dojiDoMal/Heatbed_8051/3DPrinter_Heatbed.PDF

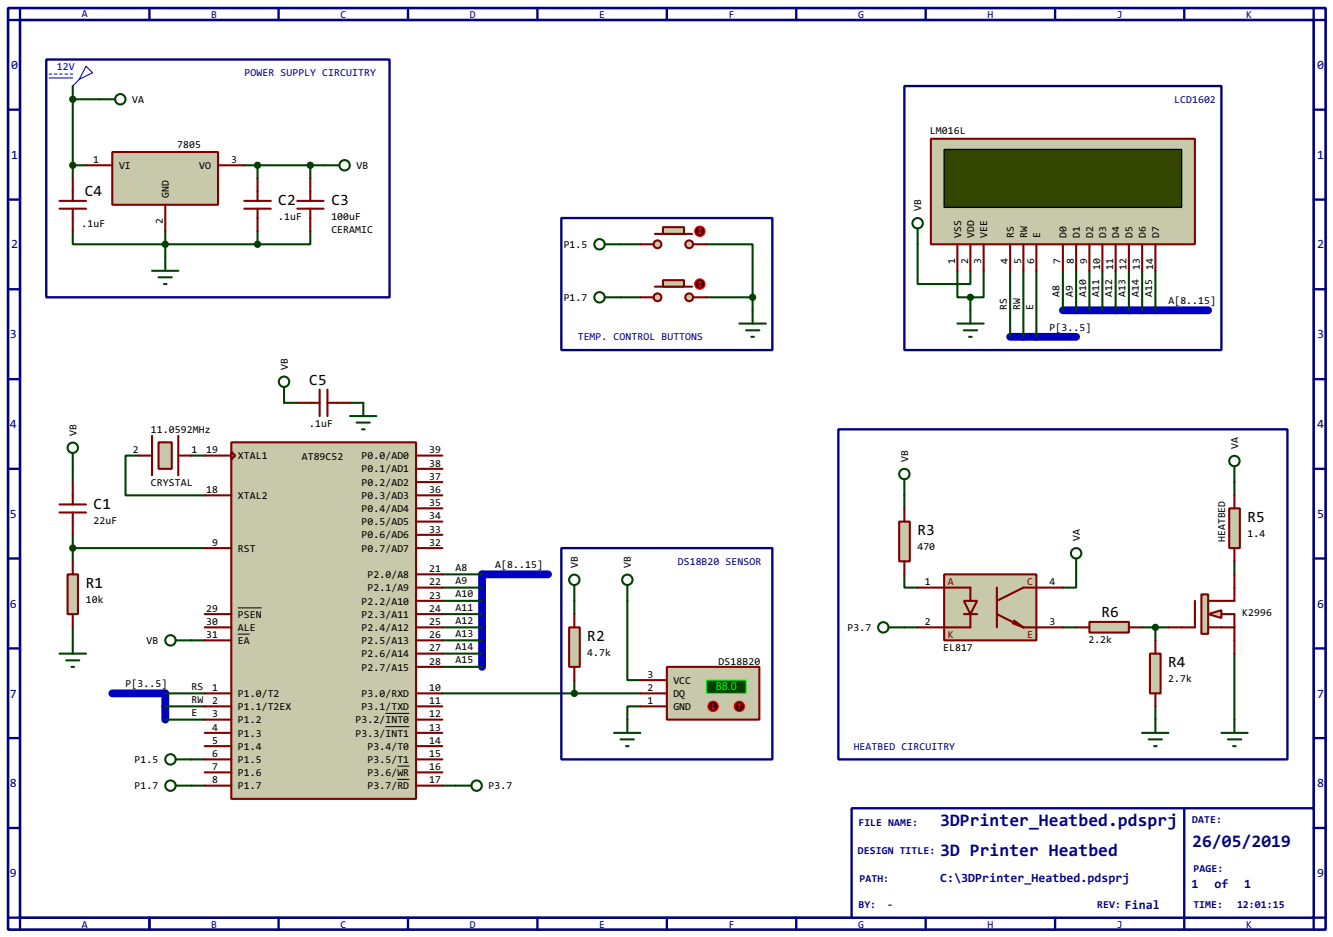
[picture p7: page 1]

FILE NAME:
DESIGN TITLE: 3D Printer Heatbed
