dojiDoMal/Heatbed_8051/(list of files, drawings)

Other design files:
3DPrinter_Heatbed.pdsprj
