dojiDoMal/Heatbed_8051/(commit log)

2019-06-23 8051 Assembly source code
2019-06-23 Power supply scheme
2019-06-23 Temperature sensor scheme
2019-06-23 Buttons scheme
2019-06-24 Heatbed scheme
2019-06-24 Proteus schematic images
2019-06-24 Heatbed circuitry on perfboard
2019-06-24 Final project
    [3DPrinter_Heatbed.pdsprj]
